Hybryd/HybROV/README.md

# HybROV
CROC<br>
This repository contains the Arduino code to pilot the homemade CROC underwater rov.<br>
See https://www.instructables.com/Build-Your-Own-Underwater-ROV-From-Scratch/ for the hardware parts.
