Hybryd/HybROV/Docs/Docs.pdf

## Guide de fabrication ROV

August 1, 2016

## Contents

1 Description | 2
2 Remarques diverses | 2
3 Pièces | 3
4 Construction | 4
5 Code arduino | 11
6 Stabilisation | 12
7 Idées d’amélioration | 12

## 1 Description


Figure 1: Aperçu global.


Figure 2: ROV ouvert.

## 2 Remarques diverses

- Les pièces citées ci-dessous correspondent à ce modèle de ROV précis. Elles ont été modifiées au fur et à mesure de la conception. Bien que la majeure partie des plans aient été dessinés avant la fabrication, des détails pratiques subsistent toujours. En règle générale, faire les plans en détail à l’avance réduit les mauvaises surprises.
- Lorsque vous choisissez ou fabriquez vos pièces, veillez à ce que toutes dimensions soient compatibles. Par exemple, la batterie que j’ai choisie rentre tout juste dans la coque (des rainures ont même dû être faites pour la glisser à l’intérieur).
- Les dimensions du ROV ne doivent être

– ni trop grandes : beaucoup de plomb à ajouter lors de l’étape de stabilisation pour compenser le gros volume, donc un ROV final très lourd
– ni trop petites : un manque d’espace à l’intérieur du ROV réduit la marge de manoeuvre lors d’un problème pratique (oubli d’un composant, etc.). Prévoyez assez d’espace pour les fils.

## 3 Pièces

### 3.1 Coque et support interne

- Pièces en PVC :
Quantité | Type | Longueur (mm) | Diamètre (mm)
1 | Tube droit | 150 | 140
2 | Manchon | | 140
2 | Bouchon de visite | | 140
4 | Tube en T | | 50
4 | Bouchon de visite | | 50
2 | Manchon | | 50
8 | Tube droit | 40 | 50
8 | Bouchon visite | | 40
8 | Manchon | | 40
10 | Tube en T | | 40
1 | Tube droit | 50 | 32
8 | Tube droit | 20 | 32
- du plomb pour lester (plomb de 1/2 Kg pour la chasse sous-marine)
- 2 baguettes en bois de 2m, dimensions 50mm x 50mm
- 1 plaque de plexyglass épaisseur 3mm

### 3.2 Électronique et connectique

- 1 carte compatible Arduino Mega2560 REV3 [6]
- fils (mâle/mâle)
- 1 interrupteur
- 2 connecteurs molex 4 broches (1 femelle et 1 mâle)
- 2 joysticks analogiques (axes X/Y + boutton central) [4]
- 2 câbles cat6 RJ45 : 1 rouleau de 50m et un autre de longueur quelconque
- 3 adaptateurs d’extension de câble cat6 RJ45 femelle/femelle
- 3 dual H-bridge
- 2 spots blancs DEL 5W 12V DC (310-320 lumens) [5]
- 1 batterie rechargeable 12V 12 A.h de dimensions 151mm x 98mm x 95mm
- 1 module de régulation de tension LM2596 DC 1.3–37V [8]

### 3.3 Propulsion

- 4 pompes à cale 12V DC 1100GPH [7]
- 4 hélices 43x26x9mm, diamètre de l’arbre 4mm [3]
- 4 drive dog 3.18mm [2]
- 4 sections tige filetée longueur 20mm diamètre 4mm
- 4 adaptateurs d’axe diamètre 4mm [1]
- 4 colliers de serrage plastique

### 3.4 Outils et consommables

- scies à bois et à métaux
- tournevis
- lime
- papier de verre
- dremel
- fer à souder
- étain
- pinces plates/coupantes
- 1 pot de colle PVC (500 mL)
- 2 tubes de colle époxy
- boulons et écrous diamètre 3mm
- 1 gant de cuisine ou en latex (pour la télécommande)

## 4 Construction

### 4.1 Coque

### 4.1.1 Tube principal

La longueur du tube principal de la coque est de 31cm, ce qui correspond à peu près à la longueur des deux manchons de 140mm mis bout à bout.

1. Pour ma part, j’ai pris un tube de diamètre 140mm terminé par un manchon (agrandissement du tube à une de ses extrémités). J’ai coupé la partie avec le manchon, en laissant quelques centimètres de la partie à 140mm, quie j’ai collée à un manchon indépendant.
2. Collez les bouchons de visite aux extrémités.

### 4.2 Tubes supérieurs

1. Pendant que le tout sèche, assemblez deux tubes en T de diamètre 50mm, en alignant les parties perpendiculaires. Vous remarquerez que le T ne fait pas tout à fait un angle droit pour des raisons d’écoulement des fluides en plomberie. Les parties perpendiculaires ne seront donc pas tout à fait parallèles mais ce n’est pas grave pour la suite.
2. Collez un bouchon de diamètre 50mm à chaque extrémité.
3. Collez un tube de diamètre 50mm à l’extrémité des parties perpendiculaires, en en laissant dépasser 4cm environ (c’est la partie qui fera la connexion entre les tubes supérieurs et le tube principal).
4. Faites de même avec l’autre tube supérieur.
5. Une fois le tout sec, vous pouvez tester l’étanchéité du tube principal. Quelques bulles sortent au niveau du pas de vis : c’est normal. Si les bulles persistent, vérifiez le joint et serrez plus fort.
6. Marquez les endroits où les tubes supérieurs viendront rejoindre le tube principal : normalement entre 7cm et 10cm du bord du tube principal, selon la taille choisie.
7. Percez la coque principale : il vaut mieux que le trou soit légèrement étroit pour que les tubes forcent en les glissant dedans.

8. Collez les deux tubes supérieurs au tube principal. Ne lésinez pas sur la colle. Si le tube dépasse à l’intérieur, il faudra le poncer par la suite, en prenant garde de conserver l’étanchéité du tout.
9. Une fois le tout sec, vérifiez de nouveau l’étanchéité. Lors des premiers tests, la coque fuyait en plusieurs endroits, surtout au niveau des tuyaux supérieurs. Si c’est le cas, repérez les fuites et ajoutez-y de la colle PVC.

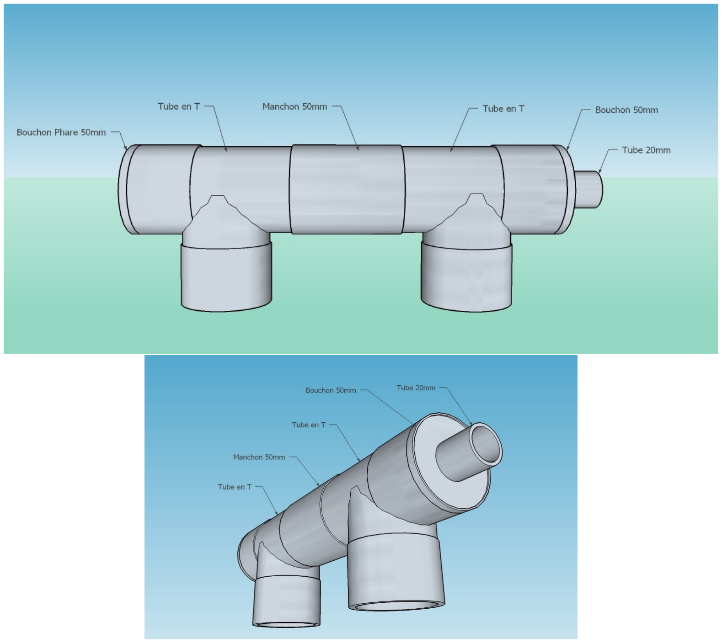
[picture p27: figure]

Figure 3: Tube supérieur.

### 4.2.1 Pieds

1. Procédez de la même manière que pour les tubes supérieurs : 2 tubes en T, 2 bouchons, 3 morceaux de tubes droit, le tout en diamètre 40mm. Collez les 4 pieds au tube principal. Inutile de le percer cette fois, vous devrez cependant adapter les tubes en contact avec la coque en fonction de la courbure de celle-ci.
2. Vérifiez que la coque est droite en la posant sur une surface plate.

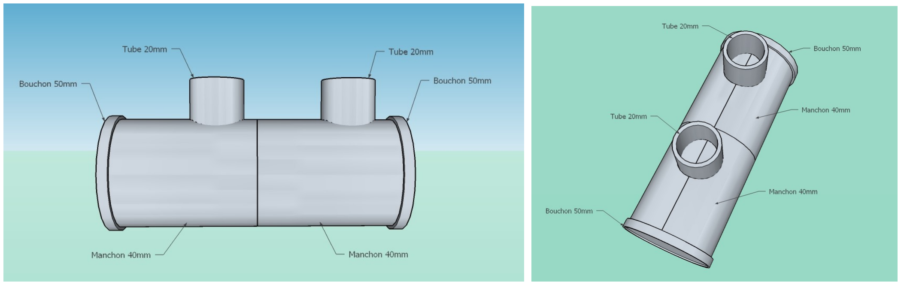
[picture p28: figure]

Figure 4: Pied.

### 4.2.2 Phares et entrée/sortie de la connectique

1. Déterminez l’avant du ROV.
2. Découpez un disque dans le bouchon avant d’un des tubes supérieurs, d’un rayon de 2cm environ (le même rayon que celui des ampoules LED en réalité).
3. Découpez un disque en plexyglass de sorte qu’il puisse se loger sur le bouchon troué.
4. Collez le disque de plexyglass sur le bouchon avec de la glue. Faites sécher en posant un objet lourd sur le disque de plexyglass afin de les serrer convenablement.
5. Faites de même avec l’autre bouchon supérieur avant.


Figure 5: Tube supérieur avec phare.

### 4.2.3 Support caméra (optionnel)

1. Découpez un tube PVC de diamètre 40mm de longueur 40mm puis coupez-le dans la longueur pour obtenir un U.
2. Collez ce U sur la partie supérieure avant du tube principal, de façon à former un dôme. Vous pouvez visser votre support à caméra dans cette pièce sans compromètre l’étanchéité du ROV.

Remarque. Le support caméra n’est pas présent sur le modèle 3D.

### 4.3 Moteurs et câble réseau

1. Découpez deux morceaux de tube PVC de diamètre 20mm et de longueur 40mm.
2. Percez les bouchons supérieurs arrières en leur centre pour faire passer ces tubes de 20mm.
3. Faites passer une extrémité du rouleau de câble RJ45 à travers un tube de 20mm et glissez ce dernier dans le trou effectué dans un des deux bouchons. Collez le tube sur le bouchon en le laissant dépasser de 25mm à l’extérieur. Le câble doit dépasser sur une longueur d’environ 10cm.
4. Remplissez le tube de colle époxy. Veillez à ce que le câble soit bien au milieu de la colle époxy lors du séchage, et non contre une paroi du tube.
5. Collez de la même manière l’autre tube de 20mm au bouchon restant.
6. Attachez les moteurs avec des colliers de serrage et de la ficelle aux endroit indiqués sur les photos. Vous pouvez aussi choisir de fabriquer des supports plus solides en PVC collés à la coque.
7. Faites passer les fils des moteurs à travers le tube 20mm du dernier bouchon supérieur arrière et faites-les sortir par le tube principal de la coque (140mm) au travers de la jonction avec le tube supérieur (voir figure).
8. Après avoir suffisamment tiré les fils pour laisser le moins de jeu possible (pas trop non plus!), remplissez de colle époxy le tube 20mm pour figer les fils moteurs. Attention : en collant les câbles, la torsion de ceux-ci lors du vissage du bouchon peut déterorier la colle époxy à long terme. Veillez à prendre en compte cette torsion lors du collage : il faut qu’aucune torsion ne soit appliquée sur les fils lorsque le bouchon est vissé.

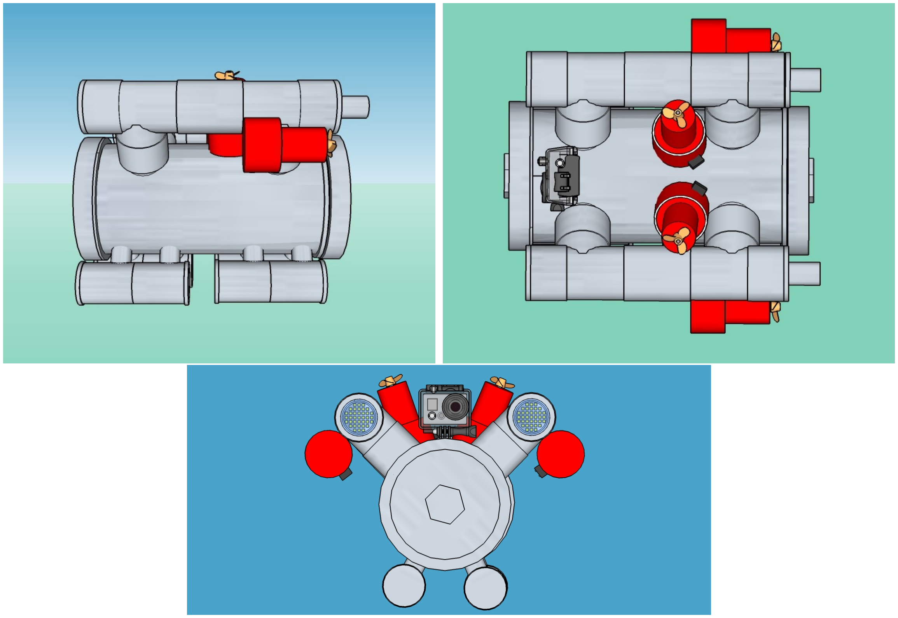
[picture p29: figure]

Figure 6: Châssis interne.

### 4.4 Télécommande

Le diamètre utilisé pour la télécommande est de 40mm. Cependant, j’ai rencontré des difficultés à rentrer les composants à l’intérieur donc je conseillerais plutôt un diamètre de 50mm.
La longueur de la télécommande est de 15cm.
1. Assemblez deux manchons de PVC et terminez-le avec deux bouchons pour former un tube étanche: la télécommande.
2. Découpez deux tubes de diamètre 40mm et de longueur 30mm.
3. Percez la télécommande pour faire passer ces tubes en deux endroits distants de 6cm à 9cm (selon vos préférences).
4. Collez les tubes à la télécommande de façon à ne rien laisser dépasser à l’intérieur. Au pire, vous réduirez la longueur des tubes par la suite.
5. Découpez deux extrémités de doigt de gant de cuisine, retournez-les et placez sur les tubes perpendiculaires à la manette.
6. Fixez les deux joysticks sur une baguette de 5mm x 5mm de longueur 13cm, en les séparant du même écart que celui choisi pour les tubes perpendiculaires à la manette.
J’ai choisi d’orienter les broches vers le centre de la télécommande pour rassembler les fils.
7. Connectez les fils aux joysticks et soudez-les aux broches d’un adaptateur femelle/femelle RJ45.
8. Glissez le tout dans la télécommande et immobilisez-le si besoin. Testez l’accès aux joysticks au travers des tubes perpendiculaires. Pour ma télécommande, j’ai enlevé les coques arrondies des joysticks.
9. Dans un des bouchons de la télécommande, procédez comme pour les bouchons supérieurs arrières de la coque, en y faisant traverser un tube de 20mm de diamètre et 30mm de long.
10. Comme pour le premier bouchon supérieur arrière, faites passer une extrémité du rouleau de câble RJ45 à travers le tube de 20mm et glissez ce dernier dans le trou effectué du bouchon. Collez le tube sur le bouchon en le laissant dépasser de 25mm à l’extérieur.
11. Branchez le câble à l’adaptateur RJ45 de la télécommande.
12. Notez la longueur de câble nécéssaire pour faire rentrer correctement les joysticks, les fils et l’adaptateur à l’intérieur de la télécommande. Puis remplissez le tube 20mm avec de la colle époxy pour figer le câble RJ45.
13. Votre télécommande est prête!

### 4.5 Châssis interne

Longueur 127mm, Largeur : 116mm, Hauteur : 90mm.

1. Construisez le chassis selon le plan avec des baguettes 8mm x 8mm (Figure 7).
2. Calez la batterie avec du carton si besoin.
3. Fixez les composants électroniques avec des vis 3mm et colliers de serrage (Figure 8)..

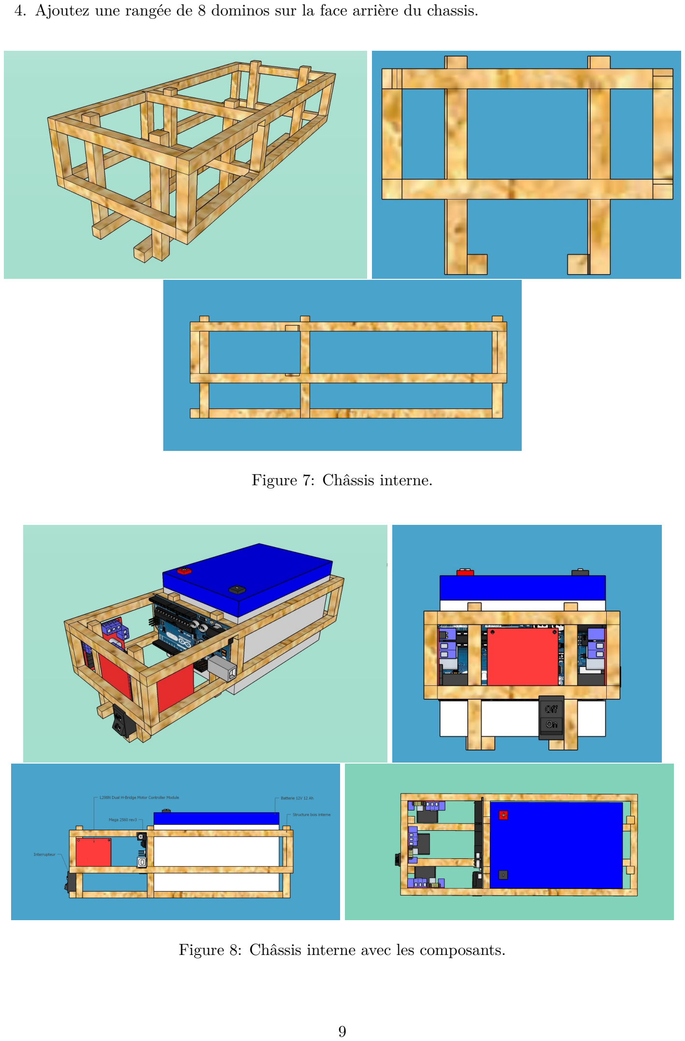
[picture p30: page 9]

4. Ajoutez une rangée de 8 dominos sur la face arrière du chassis.

Figure 7: Châssis interne.

Figure 8: Châssis interne avec les composants.

### 4.6 Câblage

Voir le schéma global : Figure 9.

Remarque. L’ensemble de mes fils étant scotchés entre eux (et par manque de rigueur au niveau de leur étiquetage), il m’a été difficile d’identifier certaines connexions. Cela ne concerne qu’une éventuelle inversion des pôles positifs et négatifs des moteurs. Il se peut donc que certaines connexions ± concernant les moteurs soient inversées. Cela a pour conséquence une rotation inverse de ces derniers.
Dans tous les cas, je conseille de prendre ce schéma à titre d’exemple et de vérifier votre branchement en testant une à une chaque entrée/sortie de la carte de pilotage (en affichant les valeurs sur le port série par exemple).
Étiquetez les fils, cela vous épargnera de longues minutes à retrouver les bons branchement...


Figure 9: Connexion entre les composants du ROV

### 4.6.1 Rallonge RJ45

La rallonge n’est rien d’autre qu’un câble réseau qui relie l’extrémité du rouleau RJ45 fixée au bouchon supérieur arrière à la carte de pilotage.

1. Si vous possédez un câble RJ45 qui possède la bonne longueur, vous pouvez passez à l’étape suivante. Sinon, raccoursissez-en un à l’aide de pinces, fer à souder et gaines thermo-rétractables. Veillez à respecter les couleurs en soudant.
2. Branchez chaque fiche RJ45 à un adaptateur.
3. Branchez une extrémité du raccord à la fiche RJ45 correspondant à la télécommande.

### 4.6.2 Interfaces RJ45/Carte de pilotage et RJ45/Télécommande

Il s’agit de raccorder un câble RJ45 à un composant possédant des broches (femelles ou mâles). Ces interfaces ne sont pas nécessaires, elles ajoutent de la modularité au ROV. Vous pourrez simplement débrancher les fiches RJ45 pour une intervention sur le ROV au lieu de dessouder les fils ou débrancher les fils des composants et risquer d’oublier les correspondances.
Vous pouvez choisir de ne pas en réaliser, il faudra simplement souder les fils à broches directement aux câbles du rouleau RJ45.
1. Découpez une fiche RJ45 en laissant suffisamment de longueur de fil (5cm – 7cm maximum).
2. En soudant, terminez chacun des fils du câble RJ45 par un fil muni d’une broche mâle. Ce dernier sera connecté aux broches femelles de la carte de pilotage. Vous obtenez votre interface RJ45/Carte de pilotage
3. Procédez de la même manière pour construire l’interface RJ45/Télécommande en terminant avec des fils munis de broches femelles qui iront se connecter aux broches mâles des joysticks.
4. Branchez les interfaces aux adaptateurs RJ45 aux extrémités du rouleau.

### 4.6.3 Connexions

## 5 Code arduino

Le code est disponible sur GitHub XXXXX. Bien que le code soit assez simple à comprendre, voici quelques explications concernant la liaison entre les joysticks et les moteurs :

- Fonctions double HL et double HR:

– Entrées (int X, int Y) : valeurs comprises entre 0 et 1024 correspondant aux signaux X Y de sortie du joystick (A : pour le mouvement dans le plan horizontal, B : pour le mouvement vertical).

– Sortie double res : valeur comprise entre -1 et 1 indiquant la direction (positif : vers l’avant/haut, négatif : vers l’arrière/bas) ainsi que la vitesse (0 : aucune, 1 : maximale) du mouvement.

- Partie // MOTORS // dans la fonction principale void loop():
valHL et valHR récupèrent le nombre fourni par les fonctions HL et HR, compris entre -1 et
1. En fonction du signe de ces valeurs, le ROV avance ou recule, la vitesse étant contrôlée par la valeur absolue de ce nombre. Il en va de même pour les moteurs verticaux.

## 6 Stabilisation

Si vous immergez le ROV à ce stade, vous observerez un sérieux déséquilibre de masse sur l’axe longitudinal (avant/arrière). En effet, l’arrière est beaucoup trop lourd par rapport à l’avant à cause de la batterie et des moteurs. Il faut donc ajouter du poids à l’avant, tout en atteignant une flottaison nulle, pour que le ROV soit entre deux eaux. Cette partie est assez délicate et nécessite de la patience.

1. Remplissez d’eau une baignoire ou un bac assez grand pour accueillir le ROV.
2. Glissez le châssis (avec batterie et composants) dans le tube principal et vissez bien tous les bouchons de visite. Les pieds doivent être aussi remplis d’air et hermétiquement fermés. Placez aussi la caméra (sa masse et son volume vont jouer dans la stablisation).
3. Scotchez le plomb de plongée le plus à l’avant possible, entre les deux pieds.
4. Immergez le ROV.
- S’il flotte, ajoutez du plomb à l’avant.
- S’il coule mais que seuls les 2 pieds arrières touchent le sol, ajoutez du plomb à l’avant jusqu’à ce que les 4 pieds touchent le fond (vous pouvez ajouter du sable dans les pieds avant).
- Si le ROV coule et que les 4 pieds touchent le fond, il faudra ajouter un flotteur à l’arrière. C’est le tube horizontal situé sur le bouchon de visite arrière sur mon modèle. Attention : le volume de celui-ci doit être évalué avant de le fabriquer.
5. L’objectif est d’avoir un ROV qui, une fois immergé dans l’eau :
- reste dans le plan horizontal : pas de déséquilibre de masse dans l’axe longitudinal ni transversal
- ait une flottaison nulle ou très légèrement positive : le ROV doit rester au même endroit dans l’espace ou remonter très doucement vers la surface. Ainsi, si une panne survient au fond de l’eau, le ROV aura toujours tendance à remonter.

## 7 Idées d’amélioration

1. Augmenter la longueur du ROV pour permettre d’ajuster l’emplacement de la batterie pour régler le problème de centralisation de la masse.
2. Ajouter un caisson pour webcam et un retour vidéo pour avoir un visuel en temps réel.
3. Ajouter des pinces.

## References

[1] Adaptateur d’axe. http://www.robotshop.com/eu/fr/coupleur-axe-vis-actobotics-14-4mm. html. (http://www.robotshop.com/eu/fr/coupleur-axe-vis-actobotics-14-4mm.html) Prix (sur ce site) : 5.62€.
[2] Drive dog. http://www.hobbyking.com/hobbyking/store/__12713__4mm_Drive_dog.html. Prix : 1.62€.

[3] Hélices. http://www.hobbyking.com/hobbyking/store/__61592__Turnigy_3_Blade_Boat_
Prop_3P_x_45_x_17_1pc_.html. (http://www.hobbyking.com/hobbyking/store/__61592__Turnigy_3_Blade_Boat_Prop_3P_x_45_x_17_1pc_.html) Prix : 2.54€.
[4] Joystick. https://fr.aliexpress.com/item/1pc-Free-Shipping-Higher-Quality-Dual-axis-XY-Joystick-Module-PS2-Joystick-Control-Lever-Sensor-For/32630096107.html. (https://fr.aliexpress.com/item/1pc-Free-Shipping-Higher-Quality-Dual-axis-XY-Joystick-Module-PS2-Joystick-Control-Lever-Sensor-For/32630096107.html) Prix : 0.55€.
[5] Lampe | del | 5w | 12v | dc. | | https://fr.aliexpress.com/item/
MR11-led-spotlight-4W-5W-7W-5730-SMD-Spotlight-AC-DC-12V-LED-Spot-Bulb-Light/ 32425374145.html. (https://fr.aliexpress.com/item/MR11-led-spotlight-4W-5W-7W-5730-SMD-Spotlight-AC-DC-12V-LED-Spot-Bulb-Light/32425374145.html) Prix : ≈ 2€.
[6] Mega2560 rev3 (atmega2560-16au) compatible arduino. https://fr.aliexpress.com/item/Mega-2560-R3-Mega2560-REV3-ATmega2560-16AU-CH340G-Board-ON-USB-Cable-compatible-for-arduino-No/32386948507.html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. (https://fr.aliexpress.com/item/Mega-2560-R3-Mega2560-REV3-ATmega2560-16AU-CH340G-Board-ON-USB-Cable-compatible-for-arduino-No/32386948507.html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) Prix : 5.37€.
[7] Pompes à cale. http://fr.aliexpress.com/item/MKBP-G500-12-rule-500-gph-bilge-pump-12v/32247940972.html. (http://fr.aliexpress.com/item/MKBP-G500-12-rule-500-gph-bilge-pump-12v/32247940972.html) Prix : ≈ 14€.
[8] Régulateur | de | tension | lm2596 | dc | 1.3–37v. | https://fr.aliexpress.com/item/
LM2596-DC-DC-4-5-40V-adjustable-step-down-power-Supply-module-NEW-High-Quality-Free/ 32272430344.html. (https://fr.aliexpress.com/item/LM2596-DC-DC-4-5-40V-adjustable-step-down-power-Supply-module-NEW-High-Quality-Free/32272430344.html) Prix : 0.54€.
