Hybryd/HybROV/Docs/IMG_20160730_085231.jpg

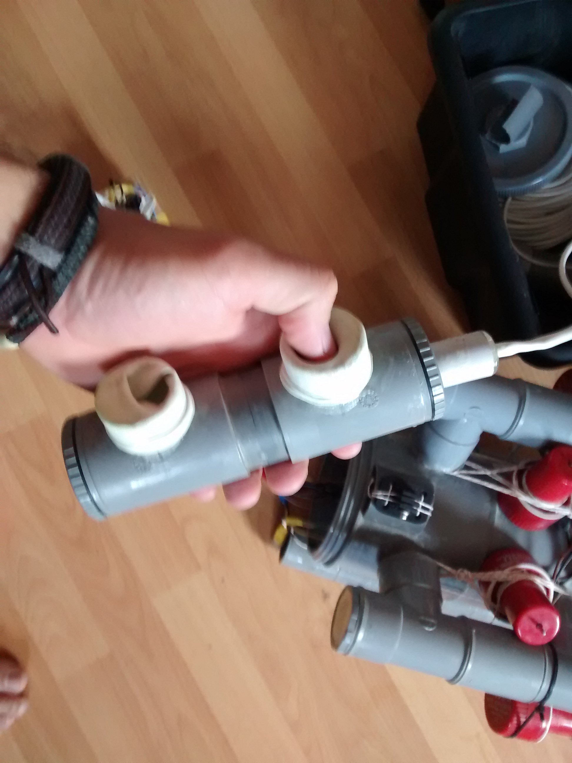
Docs/IMG_20160730_085231.jpg
