Hybryd/HybROV/Docs/IMG_20160802_100709.jpg

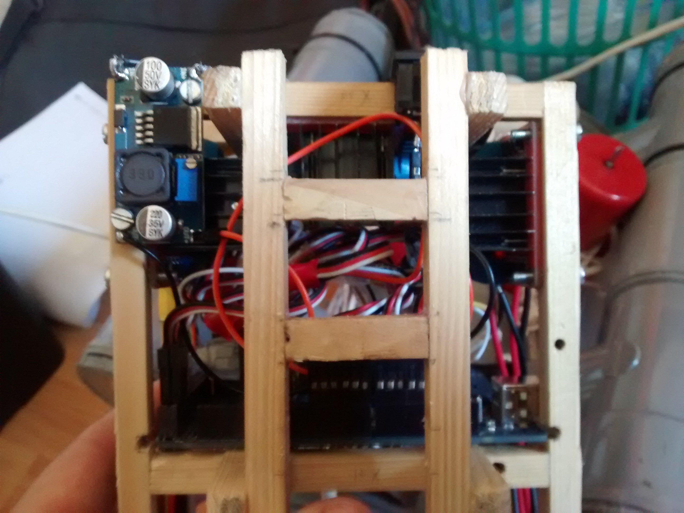
Docs/IMG_20160802_100709.jpg
