Hybryd/HybROV/Docs/IMG_20160802_100746.jpg

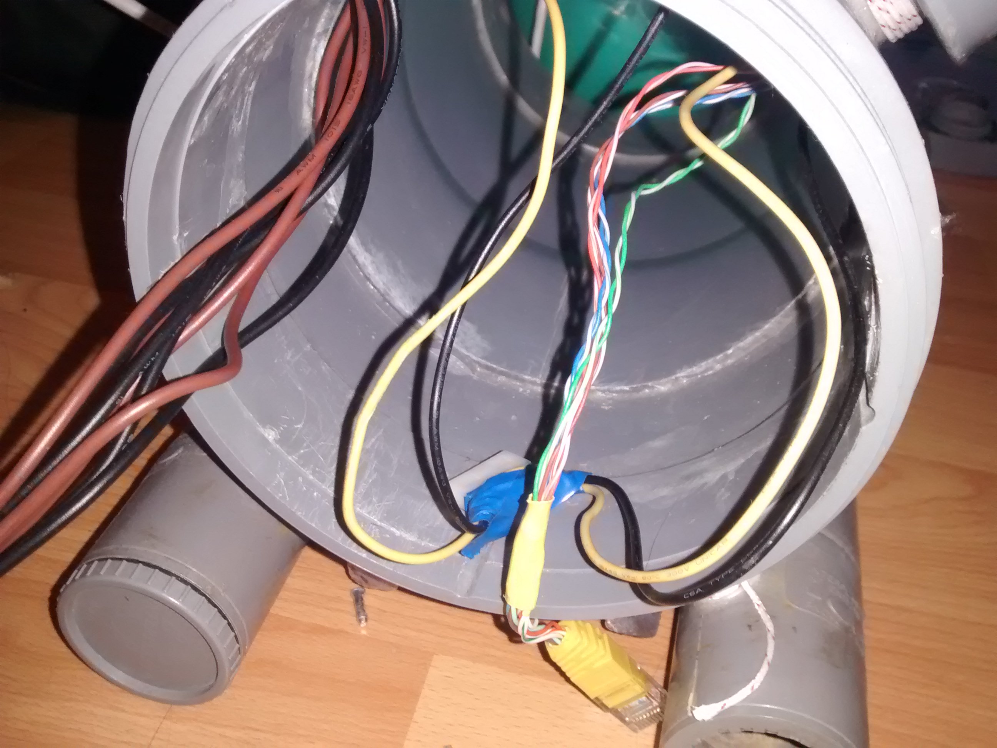
Docs/IMG_20160802_100746.jpg
