Hybryd/HybROV/Docs/IMG_20160802_100813.jpg

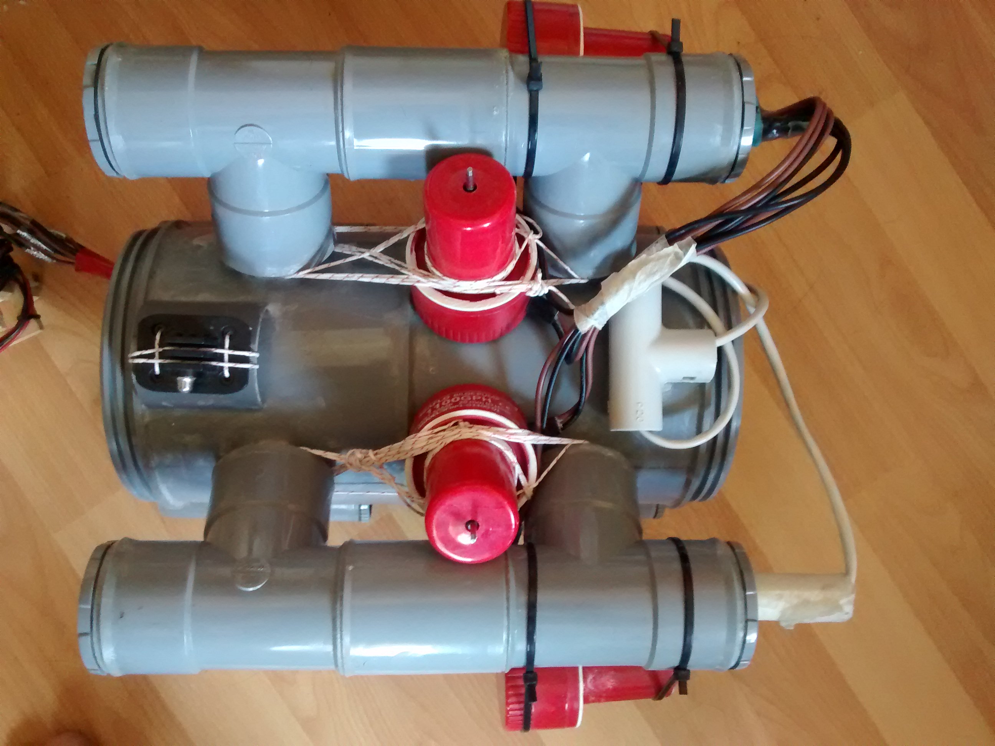
Docs/IMG_20160802_100813.jpg
