Hybryd/HybROV/Docs/IMG_20160802_100833.jpg

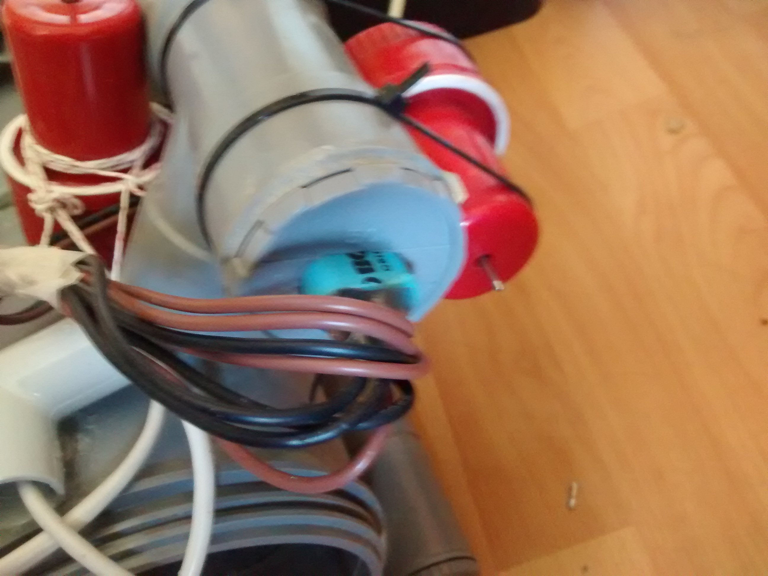
Docs/IMG_20160802_100833.jpg
