Hybryd/HybROV/Docs/IMG_20160802_101101.jpg

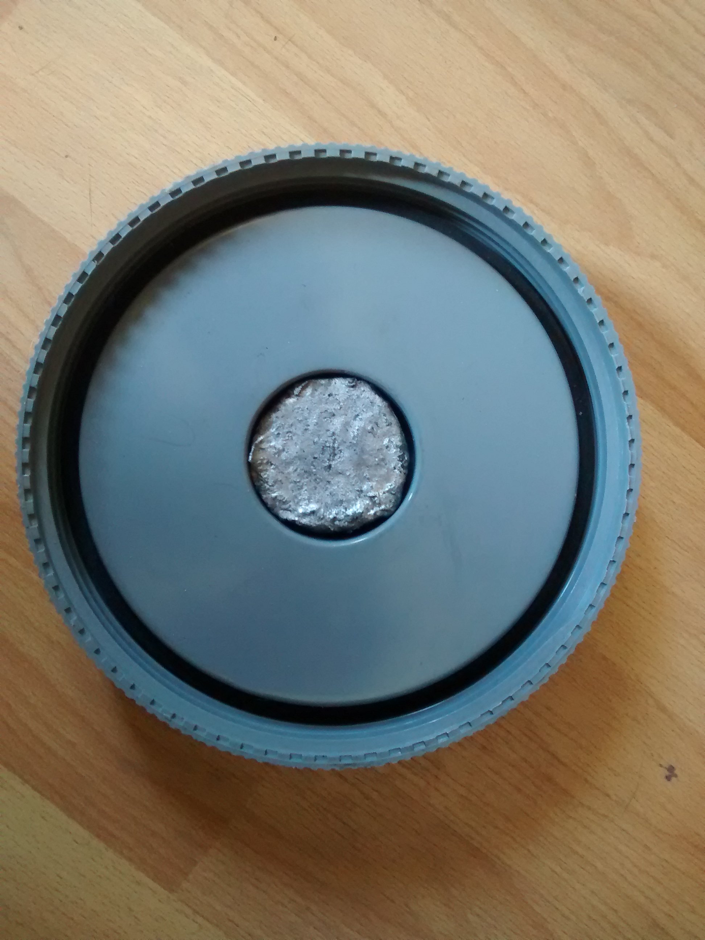
Docs/IMG_20160802_101101.jpg
