Hybryd/HybROV/Docs/IMG_20160802_101124.jpg

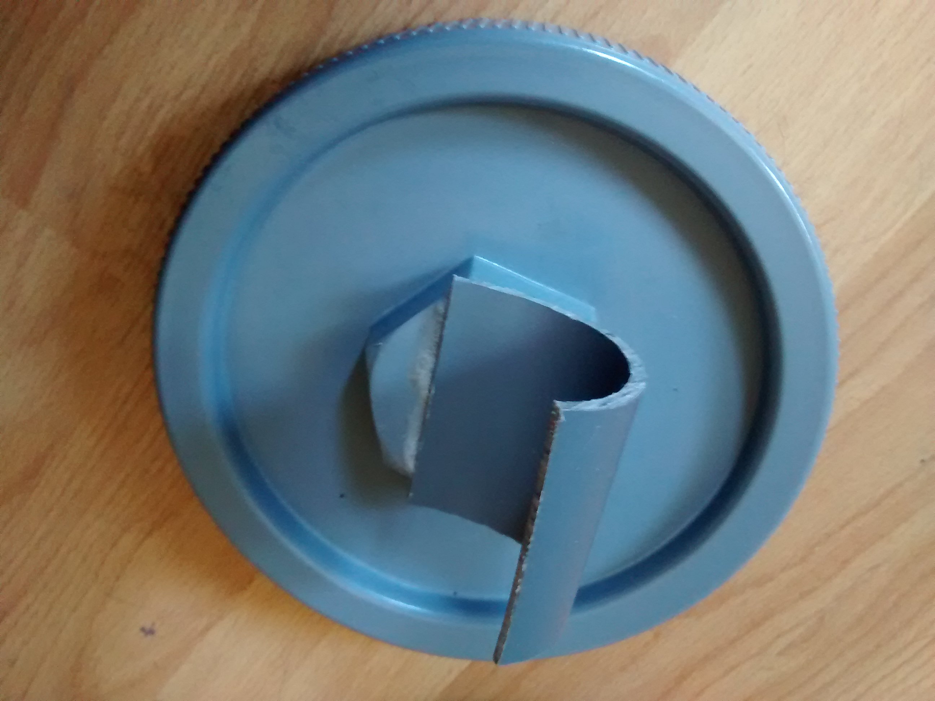
Docs/IMG_20160802_101124.jpg
