Hybryd/HybROV/Docs/ROV dessus.jpg

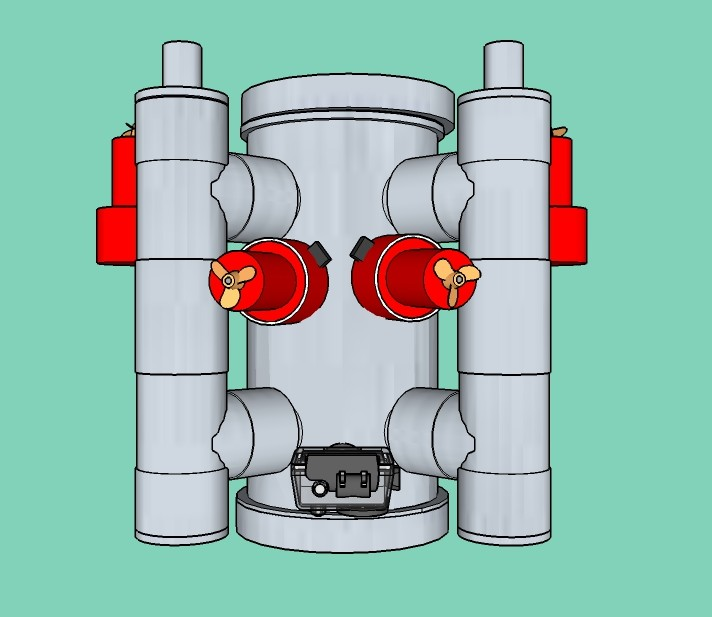
Docs/ROV dessus.jpg
