Hybryd/HybROV/Docs/ROV face.jpg

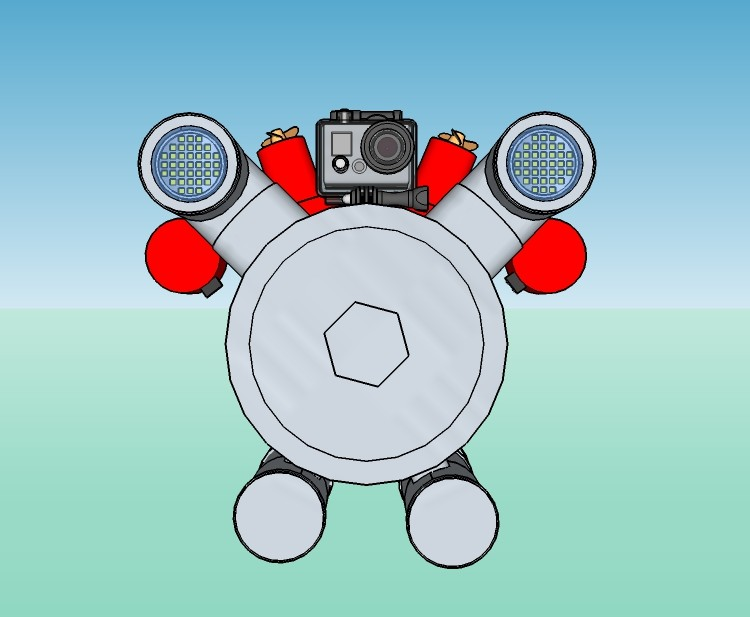
Docs/ROV face.jpg
