Hybryd/HybROV/Docs/ROV éléments internes 2.jpg

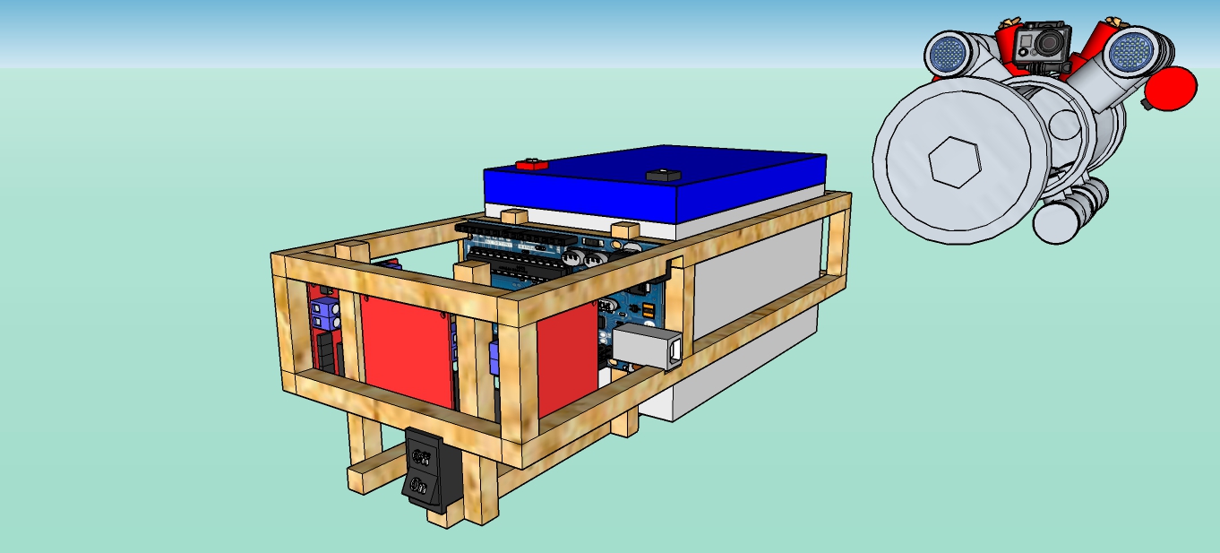
Docs/ROV éléments internes 2.jpg
