Hybryd/HybROV/Docs/ROV éléments internes.jpg

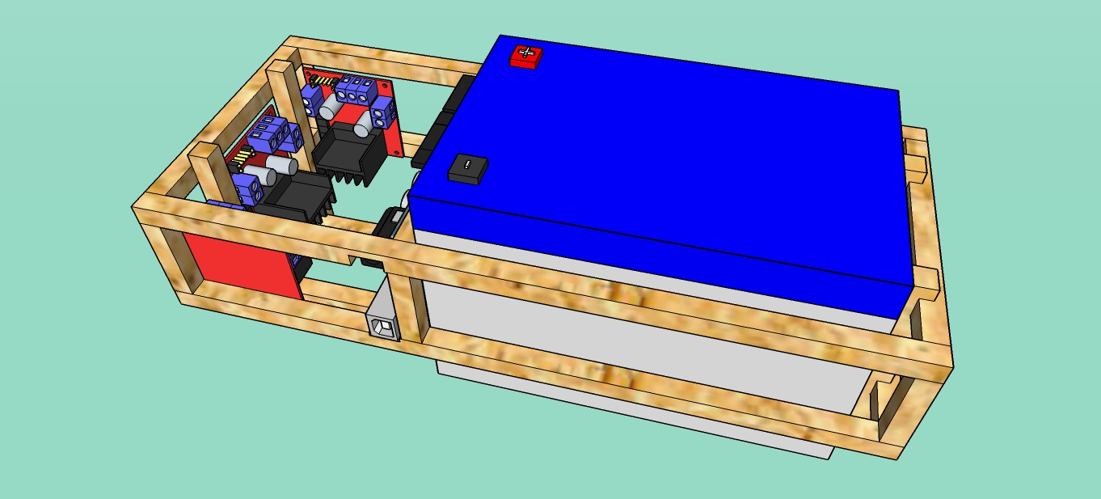
Docs/ROV éléments internes.jpg
