Hybryd/HybROV/Docs/ROVArriere.jpg

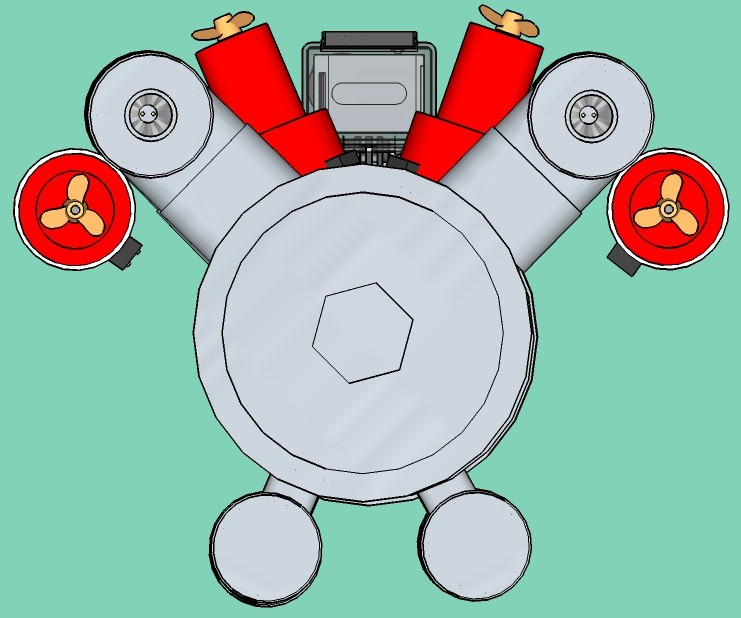
Docs/ROVArriere.jpg
