Hybryd/HybROV/Docs/ROVChassisHaut.jpg

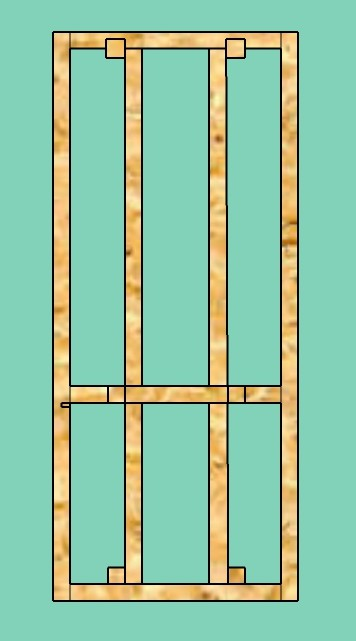
Docs/ROVChassisHaut.jpg
