Hybryd/HybROV/Docs/ROVCoque.jpg

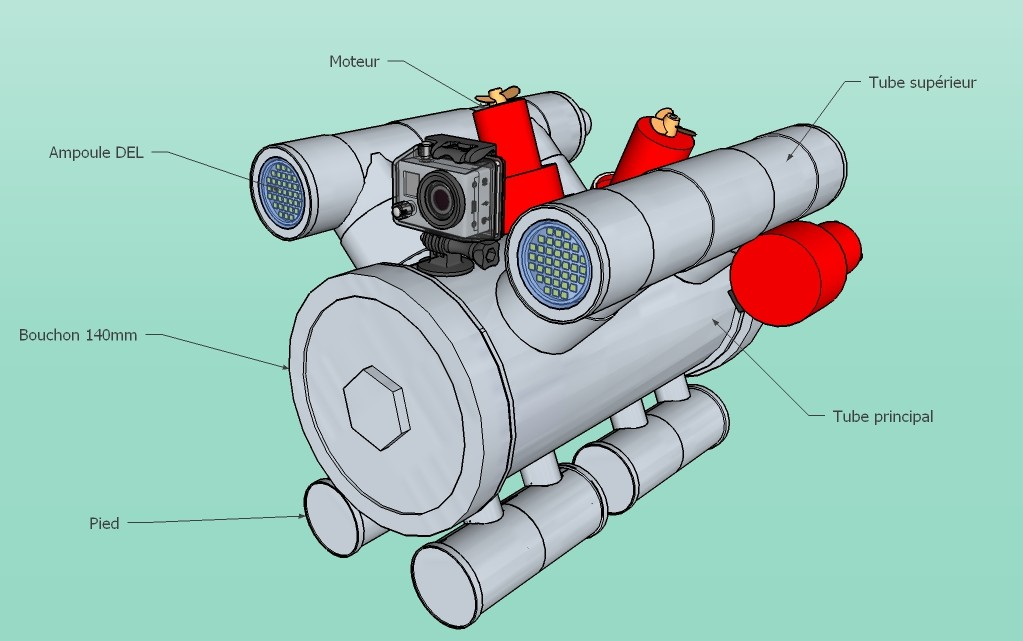
Docs/ROVCoque.jpg
