Hybryd/HybROV/Docs/ROVdessus.jpg

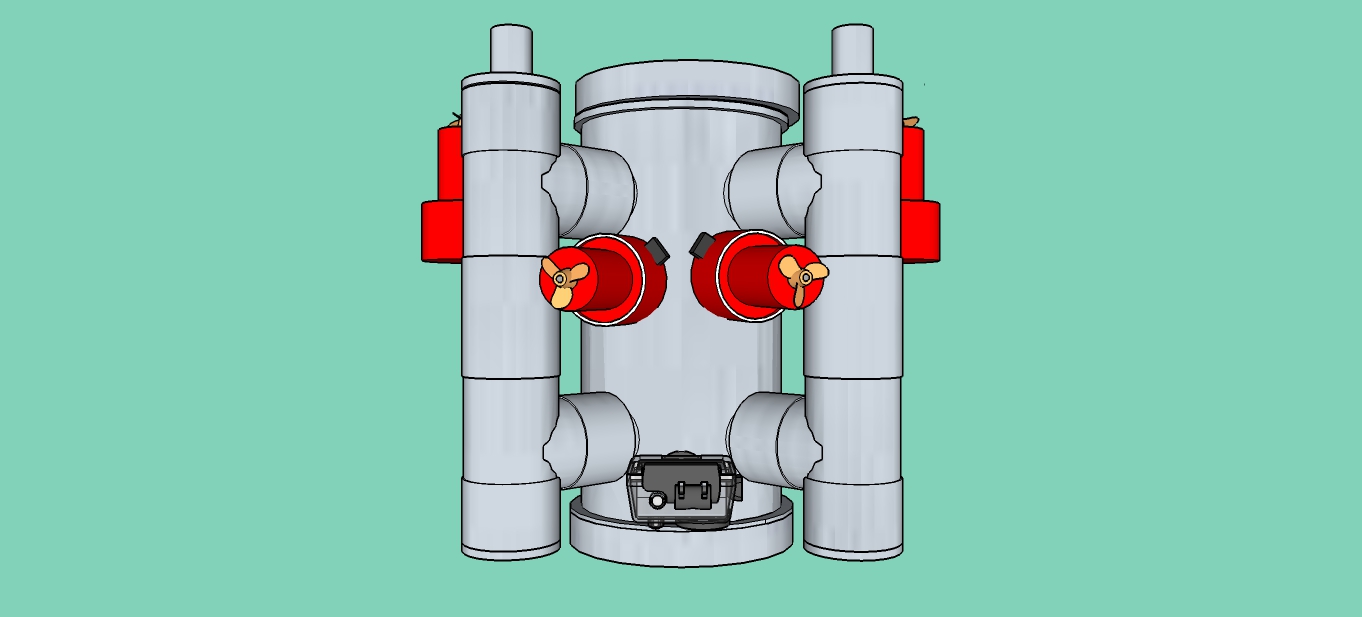
Docs/ROVdessus.jpg
