Hybryd/HybROV/Docs/ROVReel1.jpg

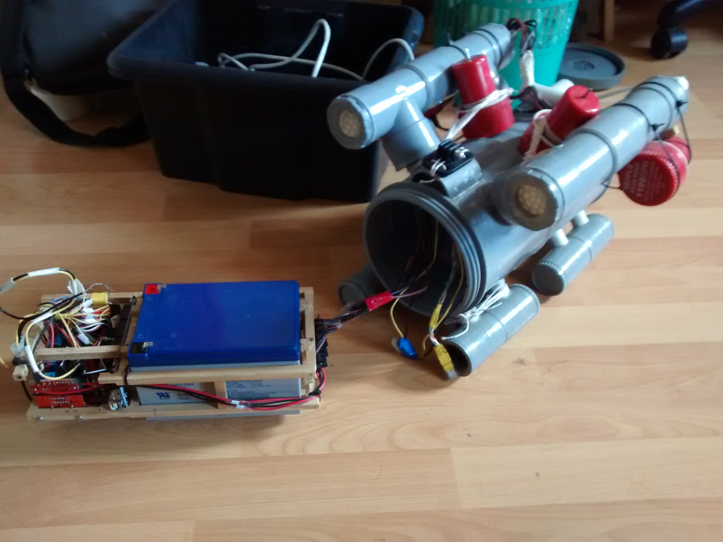
Docs/ROVReel1.jpg
