Hybryd/HybROV/Docs/ROVReelInterieur.jpg

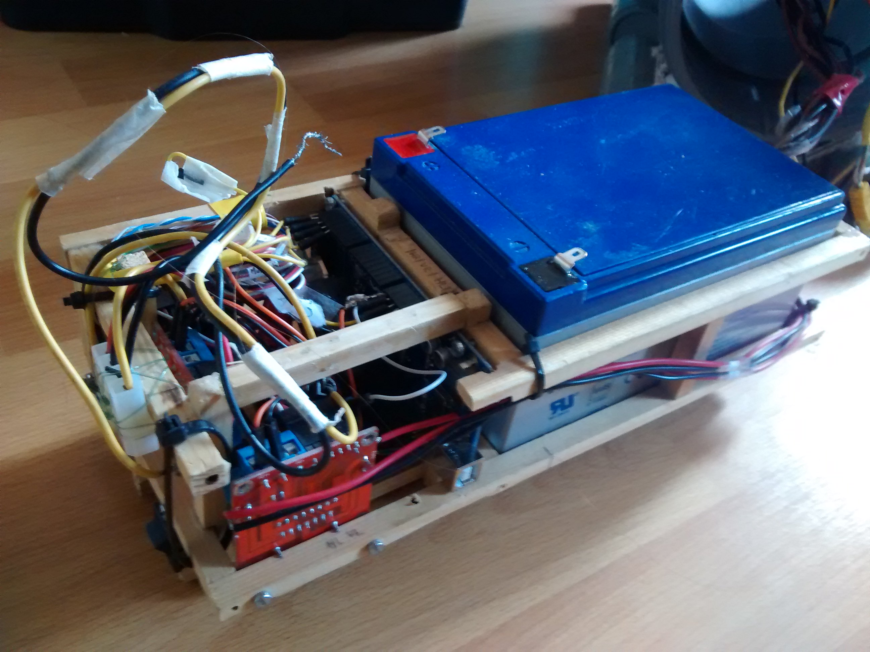
Docs/ROVReelInterieur.jpg
