Hybryd/HybROV/Electronique/schemaROV.jpg

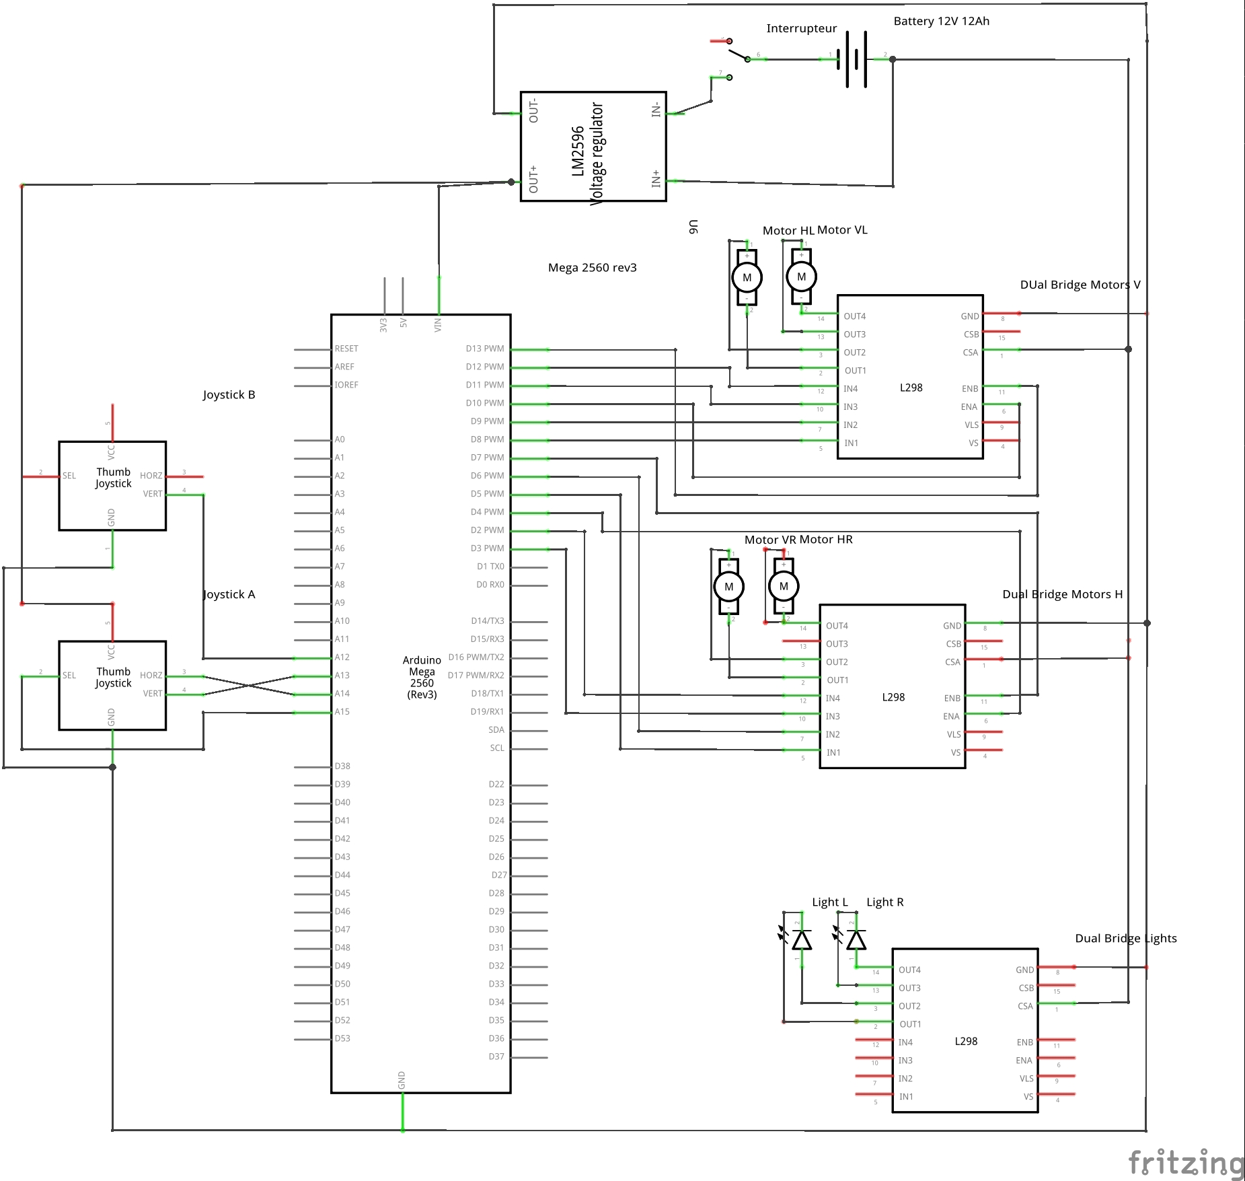
Electronique/schemaROV.jpg
