Hybryd/HybROV/(list of files, cad)

Other CAD files:
Plans/Plan.skp
