Hybryd/HybROV/Electronique/Electronique_schéma.pdf

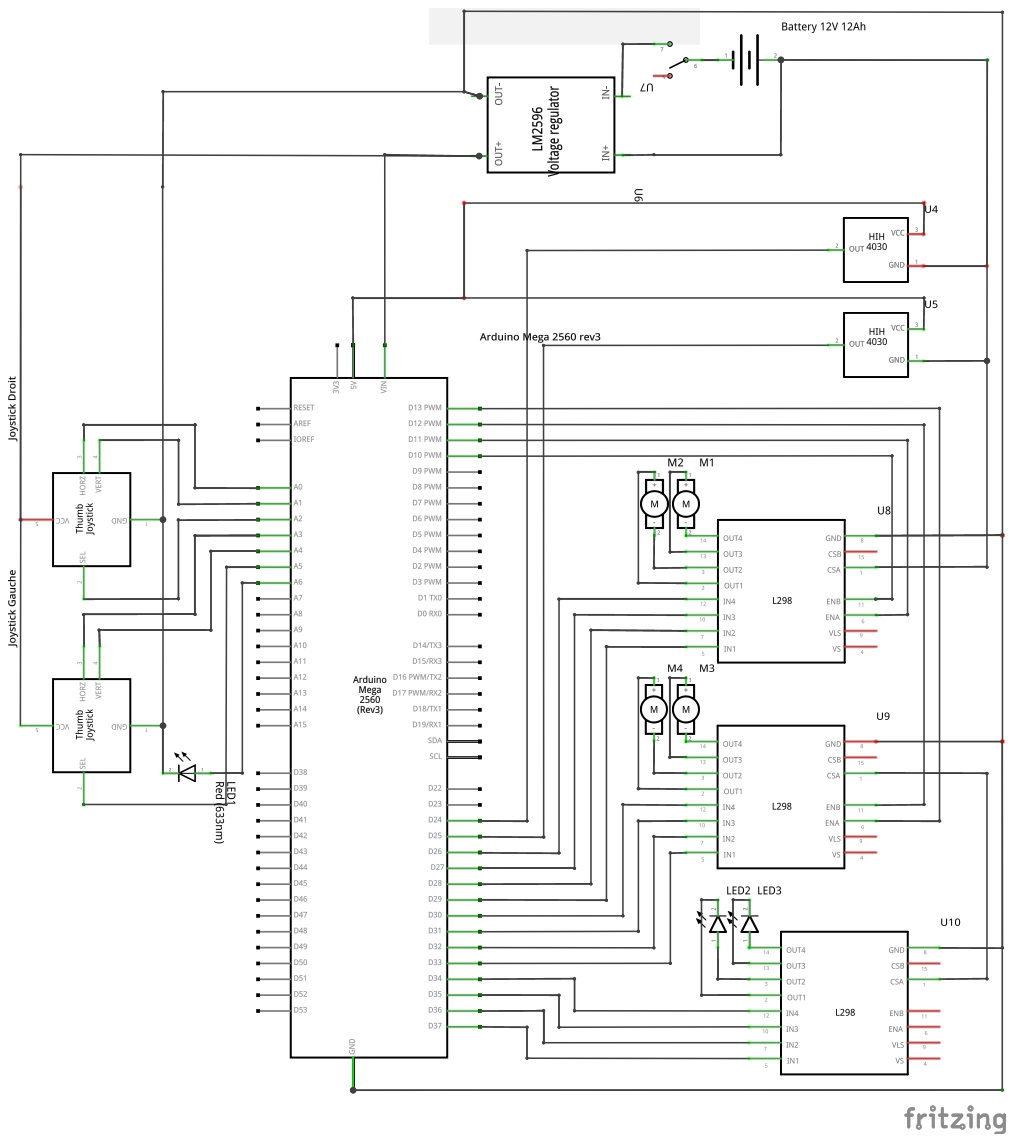
[picture p95: page 1]
