Hybryd/HybROV/(list of files, drawings)

Other design files:
Electronique/Electronique.fzz
