Hybryd/HybROV/(commit log)

2015-07-05 added Docs and Plans
    [Plan.skp, Plan1.skp, Plan2.skp]
2015-07-05 Deleted Plan1, Plan2
    [Plan1.skp, Plan2.skp]
2015-07-05 Added propellers in sketchup
    [Plan.skp]
2015-07-08 Add electronic schematics
    [Electronique.fzz]
2016-01-11 Arduino code improved
    [Connections.ods, Electronique.fzz, Plan.skp]
2016-03-23 Connections OK. Motors+Lamps tested.
    [Connections.ods]
2016-08-01 commencement du guide de fabrication
    [Electronique.fzz]
